igorwolfs/bldc-hw/rev_1/simulations/openems_trace_sims/kicad/3d_models/ATA6560-GAQW--3DModel-STEP-455599.STEP

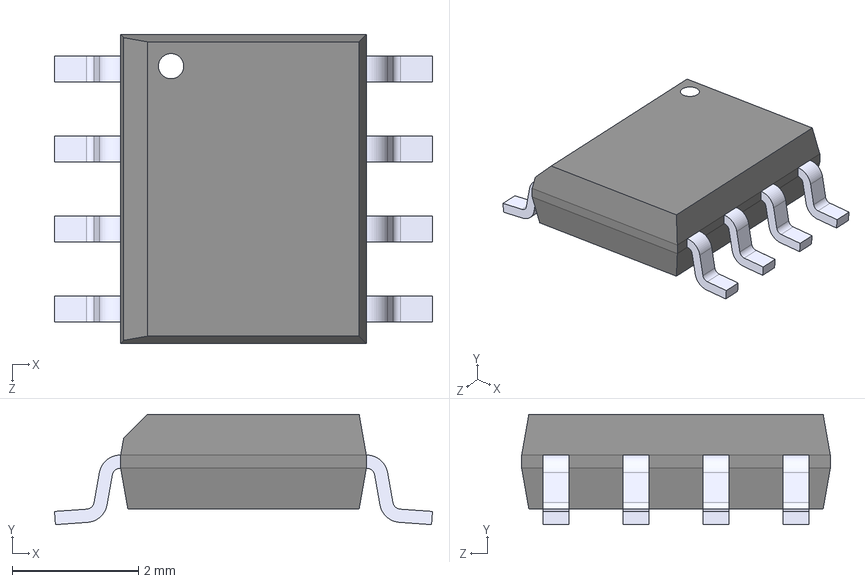
[picture p1: CAD file, 2024-08-09, an earlier design]
rev_1/simulations/openems_trace_sims/kicad/3d_models/ATA6560-GAQW--3DModel-STEP-455599.STEP
6.00 x 1.75 x 4.90 mm
