igorwolfs/bldc-hw/rev_1/simulations/openems_trace_sims/openems_files/exporting_stl.stl

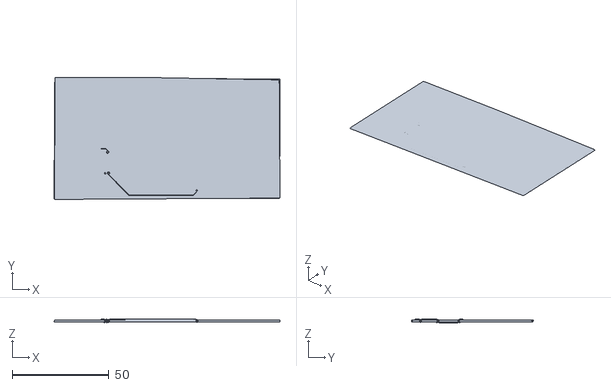
[picture p2: CAD file, 2024-12-03, an earlier design]
rev_1/simulations/openems_trace_sims/openems_files/exporting_stl.stl
116.7 x 62.9 x 1.60
