igorwolfs/bldc-hw/rev_1/simulations/openems_trace_sims/kicad/3d_models/Texas_R-PUSON-N8_USON-8-1EP_1.6x2.1mm_P0.5mm_EP0.40x1.7mm.step

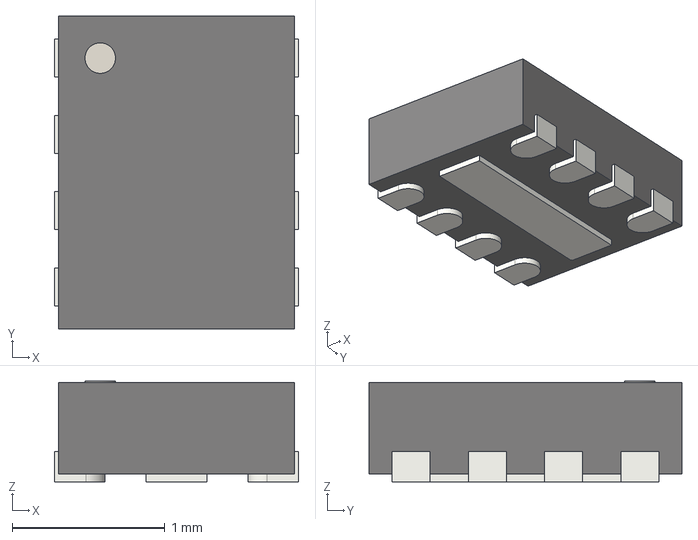
[picture p3: CAD file, 2024-08-09, an earlier design]
rev_1/simulations/openems_trace_sims/kicad/3d_models/Texas_R-PUSON-N8_USON-8-1EP_1.6x2.1mm_P0.5mm_EP0.40x1.7mm.step
1.60 x 2.05 x 0.66 mm
