igorwolfs/bldc-hw/rev_1/simulations/openems_trace_sims/kicad/3d_models/HRO_TYPE-C-31-M-12.step

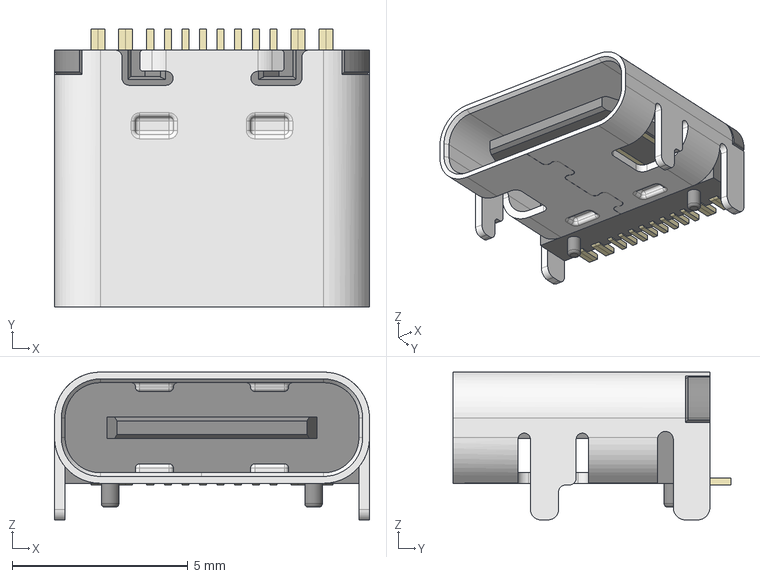
[picture p4: CAD file, 2024-08-04, an earlier design]
rev_1/simulations/openems_trace_sims/kicad/3d_models/HRO_TYPE-C-31-M-12.step
8.95 x 7.90 x 4.20 mm
