igorwolfs/bldc-hw/rev_1/simulations/openems_trace_sims/kicad/3d_models/SOIC8.STEP

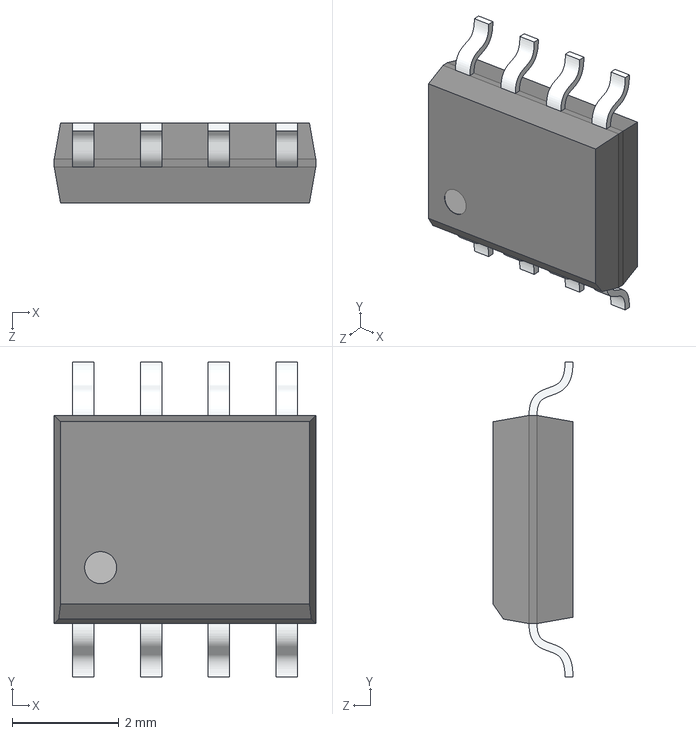
[picture p5: CAD file, 2024-08-04, an earlier design]
rev_1/simulations/openems_trace_sims/kicad/3d_models/SOIC8.STEP
4.90 x 5.90 x 1.50 mm
