igorwolfs/bldc-hw/rev_1/kicad/bldc_project.kicad_pcb

## KiCad design rev_1/kicad/bldc_project.kicad_pcb (2025-05-17, an earlier design)

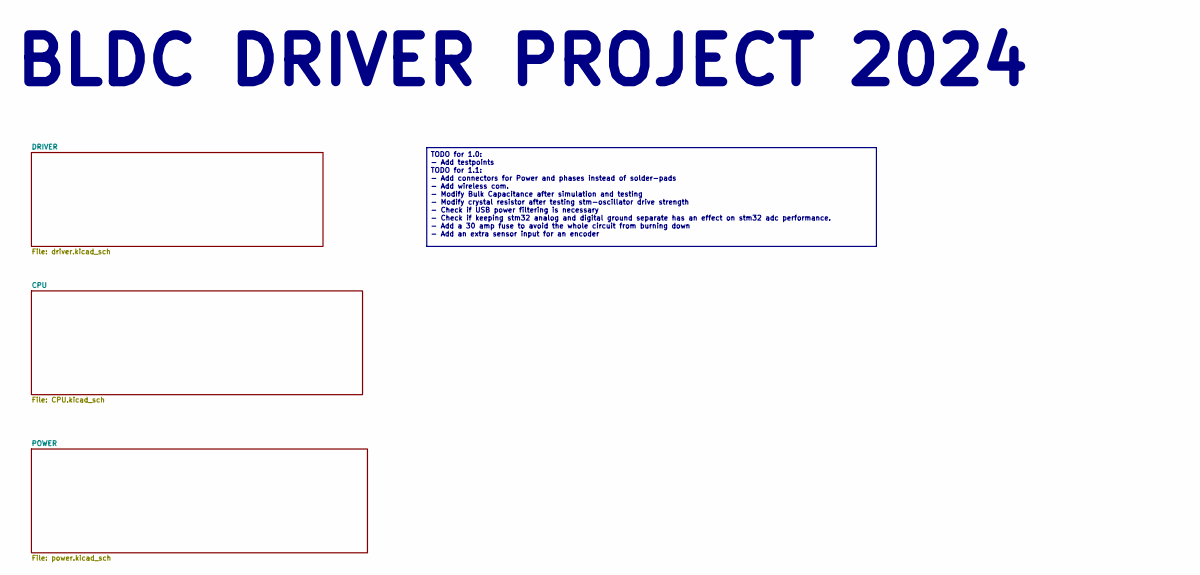
[picture p10: schematic bldc_project.kicad_sch, BLDC Driver Project]

Notes on the sheet:
BLDC DRIVER PROJECT 2024
TODO for 1.0: - Add testpoints TODO for 1.1: - Add connectors for Power and phases instead of solder-pads - Add wireless com. - Modify Bulk Capacitance after simulation and testing - Modify crystal resistor after testing stm-oscillator drive strength - Check if USB power filtering is necessary - Ch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

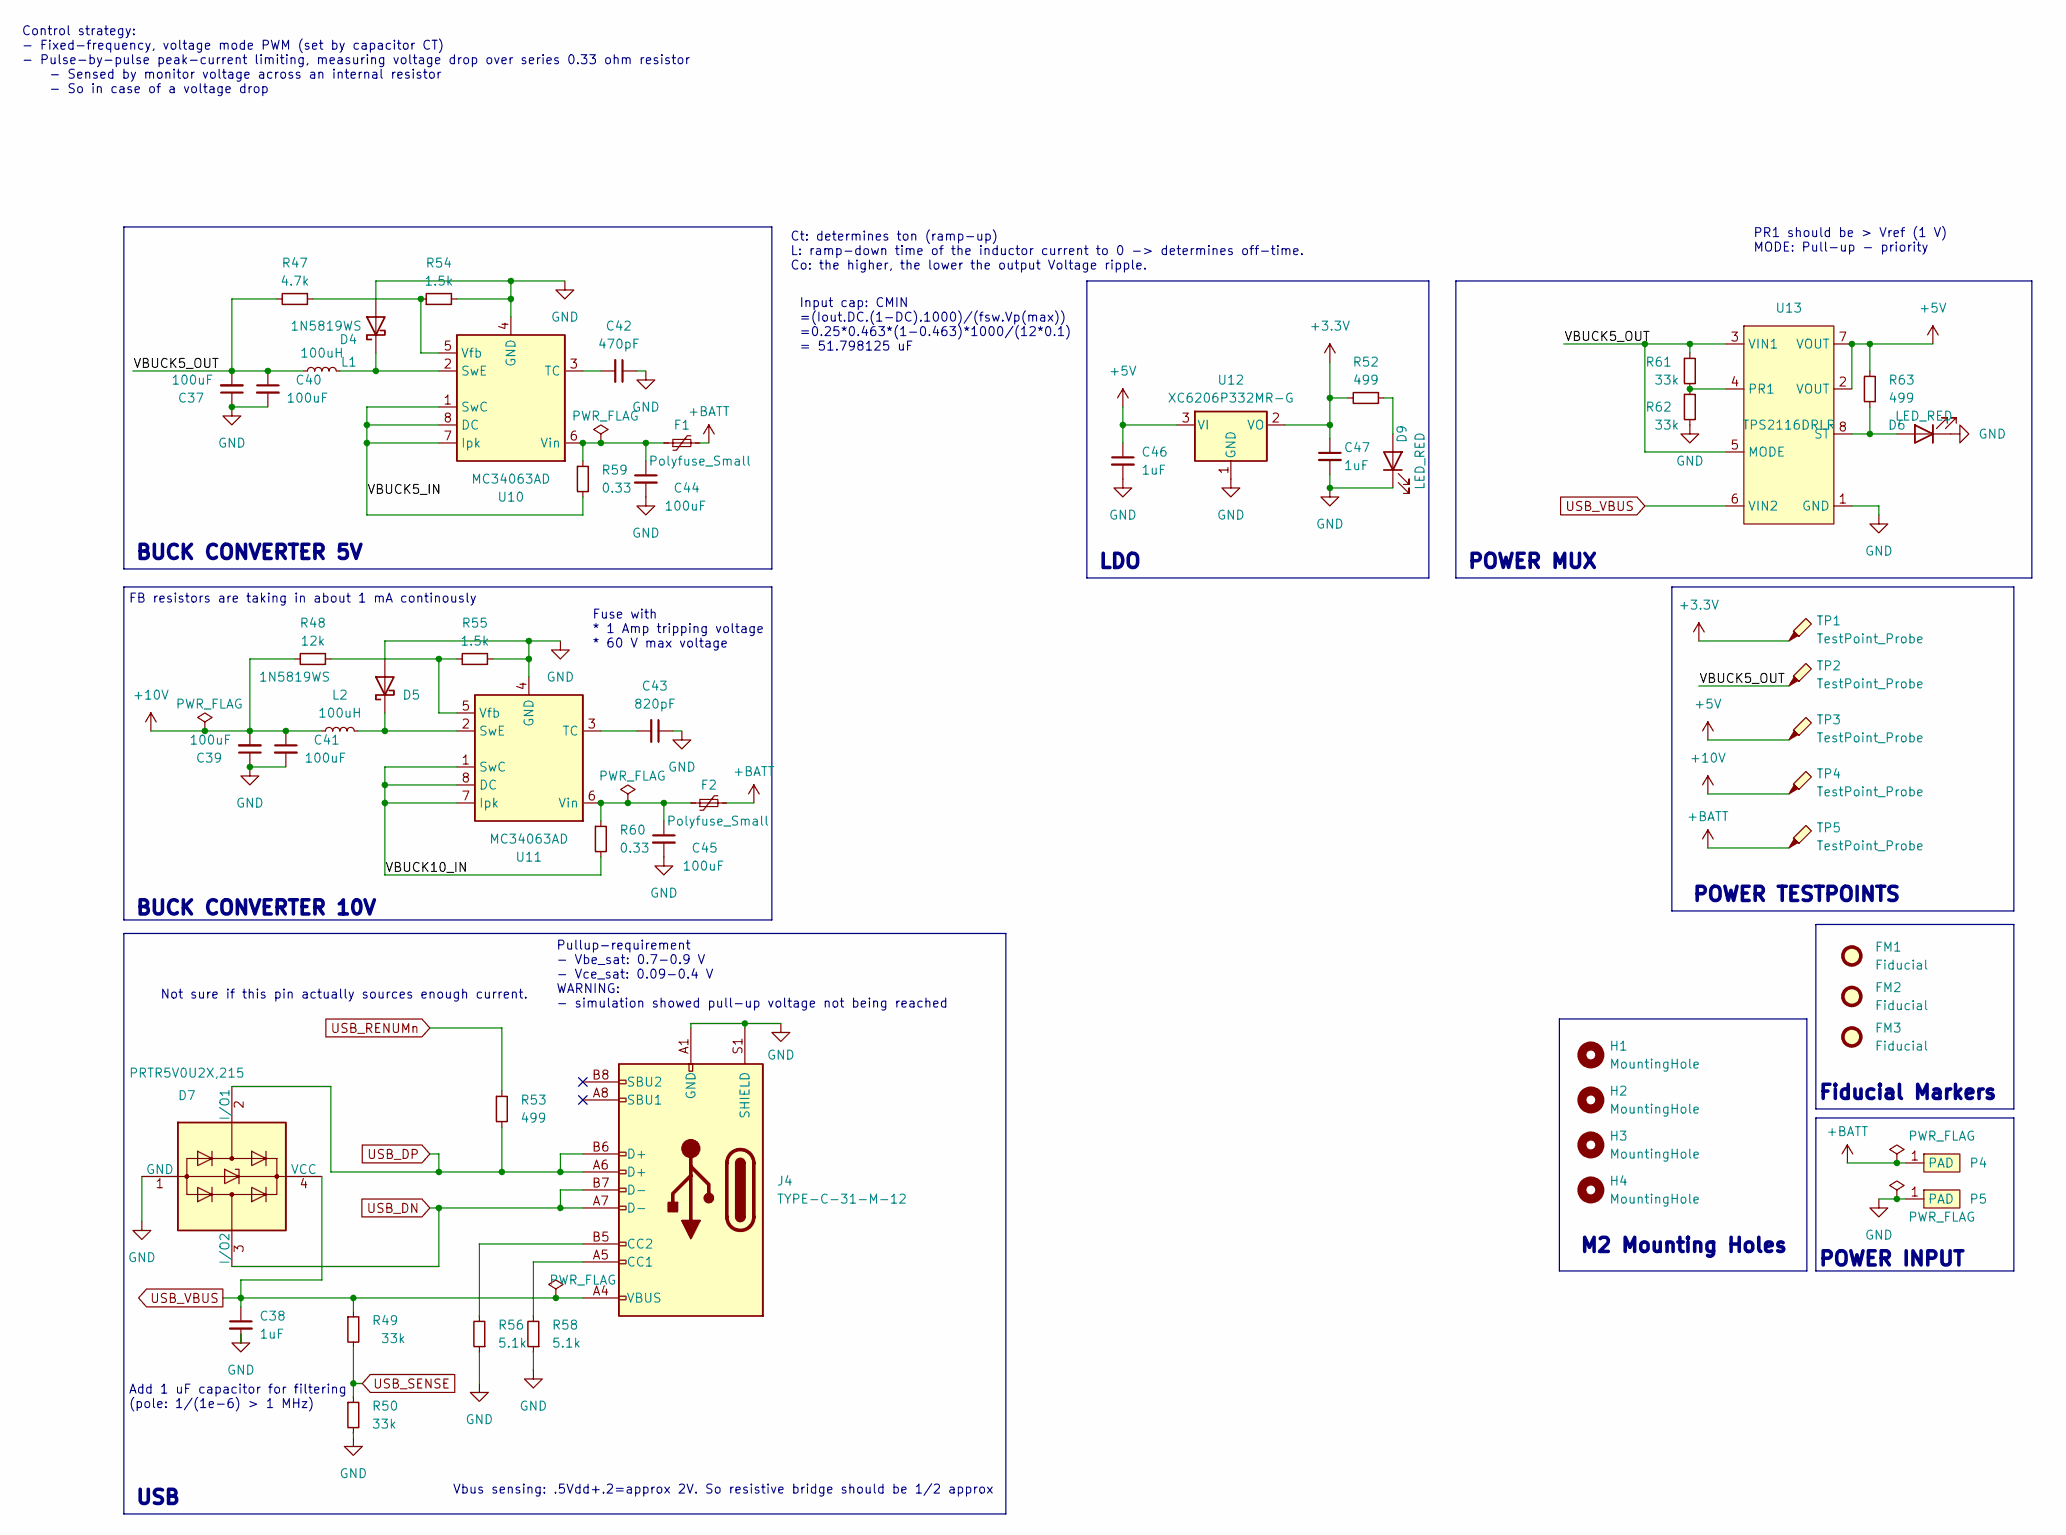
[picture p11: schematic power.kicad_sch, BLDC Driver Project]

Parts:
C37, C39, C40, C41, C44, C45: 100uF; C_1210_3225Metric; Manufacturing part numb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 CA55-B6R3M107T; LCSC Part Number C568913
C38, C46, C47: 1uF; C_1206_3216Metric; Manufacturing part numb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 CL31B105KBHNNNE; LCSC Part Number C1848
C42: 470pF; C_0603_1608Metric; Manufacturing part numb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 0603B471K500NT; LCSC Part Number C1620
C43: 820pF; C_0805_2012Metric_Pad1.18x1.45mm_HandSolder; Manufacturing part numb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 CL21B821KBANNNC; LCSC Part Number C296722
D4, D5: 1N5819WS; D_SOD-323; Manufacturing part numb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 1N5819WS; LCSC Part Number C191023
D6, D9: LED_RED; LED_0603_1608Metric; Manufacturing part numb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 F.0603.00139/P2-0603R1TS2-06T-002; LCSC Part Number C7496820
D7: PRTR5V0U2X,215; SOT-143; Manufacturing part numb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 PRTR5V0U2X,215; LCSC Part Number C12333
F1, F2: Polyfuse_Small; Fuse_1812_4532Metric; Manufacturing part numb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 BSMD1812-050-60V; LCSC Part Number C883142
FM1, FM2, FM3: Fiducial; Fiducial_1mm_Mask2mm
H1, H2, H3, H4: MountingHole; MountingHole_1.152mm_jlcpcb
J4: TYPE-C-31-M-12; USB_C_Receptacle_HRO_TYPE-C-31-M-12; Manufacturing part numb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 TYPE-C-31-M-12; LCSC Part Number C165948
L1, L2: 100uH; L_Sunlord_SWPA6045S; Manufacturing part numb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 SWPA6045S101MT; LCSC Part Number C60633
P4, P5: SolderWirePad_1x01_SMD_5x10mm
R47: 4.7k; R_0805_2012Metric; Manufacturing part numb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 0805W8F4701T5E; LCSC Part Number C17673
R48: 12k; R_0603_1608Metric; Manufacturing part numb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 0603WAF1202T5E; LCSC Part Number C22790
R49, R50, R61, R62: 33k; R_0603_1608Metric; Manufacturing part numb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 0603WAF3302T5E; LCSC Part Number C4216
R52, R53, R63: 499; R_0402_1005Metric; Manufacturing part numb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 0402WGF4990TCE; LCSC Part Number C4125
R54, R55: 1.5k; R_0805_2012Metric; Manufacturing part numb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 0805W8F1501T5E; LCSC Part Number C4310
R56, R58: 5.1k; R_0805_2012Metric; Manufacturing part numb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 0805W8F5101T5E; LCSC Part Number C27834
R59, R60: 0.33; R_1206_3216Metric; Manufacturing part numb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 1206W4J033KT5E; LCSC Part Number C25347
TP1, TP2, TP3, TP4, TP5: TestPoint_Probe; TestPoint_THTPad_D1.0mm_Drill0.5mm
U10, U11: MC34063AD; SOIC-8_3.9x4.9mm_P1.27mm; Manufacturing part numb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 MC34063; LCSC Part Number C5349988
U12: XC6206P332MR-G; SOT-23; Manufacturing part numb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 XC6206P332MR-G; LCSC Part Number C5446
U13: TPS2116DRLR; SOT-583-8; Manufacturing part numb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 TPS2116DRLR; LCSC Part Number C3235557

Connections:
+3.3V: C47.1, R52.2, TP1.1, U12.2 (VO); also elsewhere on the board
+5V: C46.1, R63.2, TP3.1, U12.3 (VI), U13.2 (VOUT), U13.7 (VOUT); also elsewhere on the board
+10V: C39.2, C41.1, L2.1, R48.2, TP4.1; also elsewhere on the board
+BATT: F1.2, F2.2, P4.1 (PAD), TP5.1; also elsewhere on the board
/POWER/VBUCK5_IN: R59.2, U10.1 (SwC), U10.7 (Ipk), U10.8 (DC)
/POWER/VBUCK5_OUT: C37.2, C40.1, L1.1, R47.2, R61.1, TP2.1, U13.3 (VIN1), U13.5 (MODE)
/POWER/VBUCK10_IN: R60.2, U11.1 (SwC), U11.7 (Ipk), U11.8 (DC)
GND: C37.1, C38.2, C39.1, C40.2, C41.2, C42.1, C43.1, C44.2, C45.2, C46.2, C47.2, D4.2 (A), D5.2 (A), D6.1 (K), D7.1 (GND), D9.1 (K), J4.A1 (GND), J4.A12 (GND), J4.B1 (GND), J4.B12 (GND), J4.S1 (SHIELD), P5.1 (PAD), R50.2, R54.2, R55.2, R56.1, R58.1, R62.2, U10.4 (GND), U11.4 (GND), U12.1 (GND), U13.1 (GND); also elsewhere on the board
unnamed: D4.1 (K), L1.2, U10.2 (SwE)
unnamed: D5.1 (K), L2.2, U11.2 (SwE)
unnamed: D6.2 (A), R63.1, U13.8 (ST)
unnamed: D9.2 (A), R52.1
unnamed: J4.A5 (CC1), R58.2
unnamed: J4.B5 (CC2), R56.2
unnamed: C42.2, U10.3 (TC)
unnamed: R47.1, R54.1, U10.5 (Vfb)
unnamed: C44.1, F1.1, R59.1, U10.6 (Vin)
unnamed: C43.2, U11.3 (TC)
unnamed: R48.1, R55.1, U11.5 (Vfb)
unnamed: C45.1, F2.1, R60.1, U11.6 (Vin)
unnamed: R61.2, R62.1, U13.4 (PR1)
USB_DN: D7.3 (I/O2), J4.A7 (D-), J4.B7 (D-); also elsewhere on the board
USB_DP: D7.2 (I/O1), J4.A6 (D+), J4.B6 (D+), R53.2; also elsewhere on the board
USB_RENUMn: R53.1; also elsewhere on the board
USB_SENSE: R49.2, R50.1; also elsewhere on the board
USB_VBUS: C38.1, D7.4 (VCC), J4.A4 (VBUS), J4.A9 (VBUS), J4.B4 (VBUS), J4.B9 (VBUS), R49.1, U13.6 (VIN2); also elsewhere on the board

Notes on the sheet:
PR1 should be > Vref (1 V) MODE: Pull-up - priority
Pullup-requirement - Vbe_sat: 0.7-0.9 V - Vce_sat: 0.09-0.4 V WARNING: - simulation showed pull-up voltage not being reached
Vbus sensing: .5Vdd+.2=approx 2V. So resistive bridge should be 1/2 approx
Not sure if this pin actually sources enough current.
Add 1 uF capacitor for filtering (pole: 1/(1e-6) > 1 MHz)
FB resistors are taking in about 1 mA continously
Fuse with * 1 Amp tripping voltage * 60 V max voltage
Input cap: CMIN =(Iout.DC.(1-DC).1000)/(fsw.Vp(max)) =0.25*0.463*(1-0.463)*1000/(12*0.1) = 51.798125 uF
Ct: determines ton (ramp-up) L: ramp-down time of the inductor current to 0 -> determines off-time. Co: the higher, the lower the output Voltage ripple.
Control strategy: - Fixed-frequency, voltage mode PWM (set by capacitor CT) - Pulse-by-pulse peak-current limiting, measuring voltage drop over series 0.33 ohm resistor - Sensed by monitor voltage across an internal resistor - So in case of a voltage drop
POWER INPUT
USB
Fiducial Markers
POWER TESTPOINTS
LDO
POWER MUX
BUCK CONVERTER 5V
BUCK CONVERTER 10V
M2 Mounting Holes

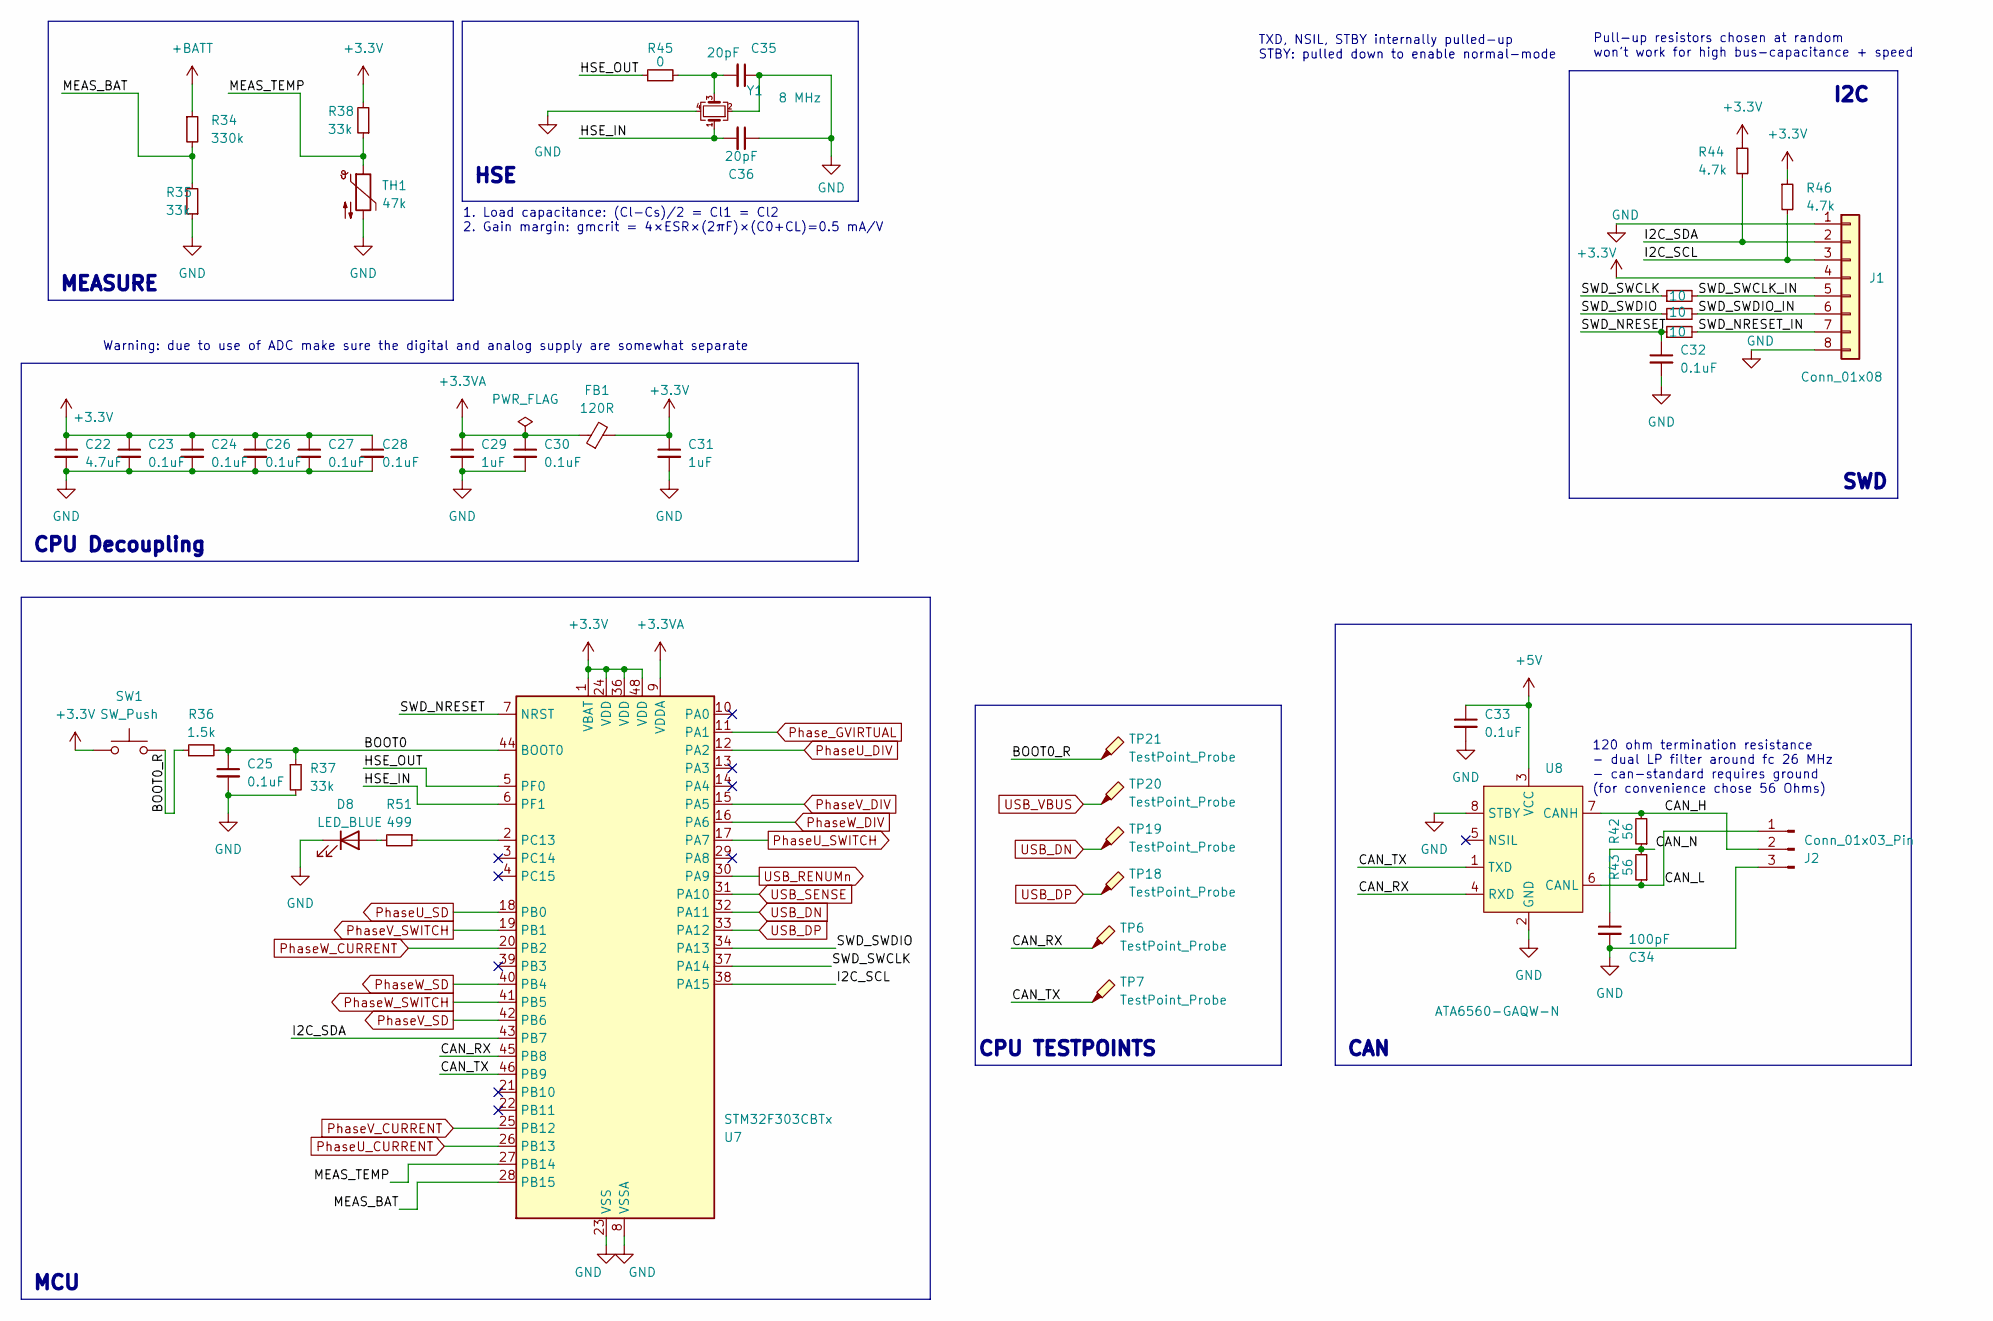
[picture p12: schematic CPU.kicad_sch, BLDC Driver Project]

Parts:
C22: 4.7uF; C_0603_1608Metric; Manufacturing part numb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 CL10A475KO8NNNC; LCSC Part Number C19666
C23, C24, C25, C26, C27, C28, C30, C32, C33: 0.1uF; C_0402_1005Metric; Manufacturing part numb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 CL05B104KB54PNC; LCSC Part Number C307331
C29, C31: 1uF; C_1206_3216Metric; Manufacturing part numb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 CL31B105KBHNNNE; LCSC Part Number C1848
C34: 100pF; C_0603_1608Metric; Manufacturing part numb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 CL10C101JB8NNNC; LCSC Part Number C14858
C35, C36: 20pF; C_0603_1608Metric; Manufacturing part numb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 CL10C200JB81PNC; LCSC Part Number C346210
D8: LED_BLUE; LED_0603_1608Metric; Manufacturing part numb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 F.0603.00026/P2-0603B1TS2-06T-001; LCSC Part Number C7496819
FB1: 120R; R_0603_1608Metric; Manufacturing part numb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 BLM18PG121SN1D; LCSC Part Number C14709
J1: Conn_01x08; PinHeader_1x08_P2.54mm_Vertical; Manufacturing part numb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 HB-PH3-25418PB2GOP; LCSC Part Number C6332201
J2: Conn_01x03_Pin; PinHeader_1x03_P2.54mm_Vertical; Manufacturing part numb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 HB-PH3-25413PB2GOP; LCSC Part Number C6332196
R34: 330k; R_0603_1608Metric; Manufacturing part numb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 0603WAF3303T5E; LCSC Part Number C23137
R35, R37, R38: 33k; R_0603_1608Metric; Manufacturing part numb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 0603WAF3302T5E; LCSC Part Number C4216
R36: 1.5k; R_0805_2012Metric; Manufacturing part numb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 0805W8F1501T5E; LCSC Part Number C4310
R41, R57, R64: 10; R_0402_1005Metric; Manufacturing part numb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 0402WGF100JTCE; LCSC Part Number C25077
R42, R43: 56; R_0603_1608Metric; Manufacturing part numb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 0603WAD560JT5E; LCSC Part Number C423025
R44, R46: 4.7k; R_0805_2012Metric; Manufacturing part numb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 0805W8F4701T5E; LCSC Part Number C17673
R45: 0; R_0402_1005Metric_Pad0.72x0.64mm_HandSolder; Manufacturing part numb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 0402WGF0000TCE; LCSC Part Number C17168
R51: 499; R_0402_1005Metric; Manufacturing part numb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 0402WGF4990TCE; LCSC Part Number C4125
SW1: SW_Push; TS-1088_w4.00xD3.00; Manufacturing part numb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 TS-1088-AR02016; LCSC Part Number C720477
TH1: 47k; R_0402_1005Metric; Manufacturing part numb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 SDNT1005X473F4050FTF; LCSC Part Number C279702
TP6, TP7, TP18, TP19, TP20, TP21: TestPoint_Probe; TestPoint_THTPad_D1.0mm_Drill0.5mm
U7: STM32F303CBTx; LQFP-48_7x7mm_P0.5mm; Manufacturing part numb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 STM32F303CBT6; LCSC Part Number C108516
U8: ATA6560-GAQW-N; SOIC-8-N8_3.9x4.9mm_P1.27mm; Manufacturing part numb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 ATA6560-GAQW-N; LCSC Part Number C2671262
Y1: 8 MHz; Crystal_SMD_3225-4Pin_3.2x2.5mm; Manufacturing part numb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 7325-0800A2010-00; LCSC Part Number C389817

Connections:
+3.3V: C22.1, C23.1, C24.1, C26.1, C27.1, C28.1, C31.1, FB1.2, J1.4, R38.2, R44.1, R46.1, SW1.1, U7.1 (VBAT), U7.24 (VDD), U7.36 (VDD), U7.48 (VDD); also elsewhere on the board
+3.3VA: C29.1, C30.1, FB1.1, U7.9 (VDDA)
+5V: C33.1, U8.3 (VCC); also elsewhere on the board
+BATT: R34.1; also elsewhere on the board
/CPU/BOOT0: C25.1, R36.2, R37.1, U7.44 (BOOT0)
/CPU/BOOT0_R: R36.1, SW1.2, TP21.1
/CPU/CAN_H: J2.2, R42.2, U8.7 (CANH)
/CPU/CAN_L: J2.1, R43.1, U8.6 (CANL)
/CPU/CAN_N: C34.1, R42.1, R43.2
/CPU/CAN_RX: TP6.1, U7.45 (PB8), U8.4 (RXD)
/CPU/CAN_TX: TP7.1, U7.46 (PB9), U8.1 (TXD)
/CPU/HSE_IN: C36.2, U7.6 (PF1), Y1.1
/CPU/HSE_OUT: R45.1, U7.5 (PF0)
/CPU/I2C_SCL: J1.3, R46.2, U7.38 (PA15)
/CPU/I2C_SDA: J1.2, R44.2, U7.43 (PB7)
/CPU/MEAS_BAT: R34.2, R35.2, U7.28 (PB15)
/CPU/MEAS_TEMP: R38.1, TH1.1, U7.27 (PB14)
/CPU/SWD_NRESET: C32.1, R41.1, U7.7 (NRST)
/CPU/SWD_NRESET_IN: J1.7, R41.2
/CPU/SWD_SWCLK: R57.1, U7.37 (PA14)
/CPU/SWD_SWCLK_IN: J1.5, R57.2
/CPU/SWD_SWDIO: R64.1, U7.34 (PA13)
/CPU/SWD_SWDIO_IN: J1.6, R64.2
GND: C22.2, C23.2, C24.2, C25.2, C26.2, C27.2, C28.2, C29.2, C30.2, C31.2, C32.2, C33.2, C34.2, C35.1, C36.1, D8.1 (K), J1.1, J1.8, J2.3, R35.1, R37.2, TH1.2, U7.8 (VSSA), U7.23 (VSS), U7.35 (VSS), U7.47 (VSS), U8.2 (GND), U8.8 (STBY), Y1.2, Y1.4; also elsewhere on the board
unnamed: C35.2, R45.2, Y1.3
unnamed: D8.2 (A), R51.2
unnamed: R51.1, U7.2 (PC13)
PhaseU_CURRENT: U7.26 (PB13); also elsewhere on the board
PhaseU_DIV: U7.12 (PA2); also elsewhere on the board
PhaseU_SD: U7.18 (PB0); also elsewhere on the board
PhaseU_SWITCH: U7.17 (PA7); also elsewhere on the board
PhaseV_CURRENT: U7.25 (PB12); also elsewhere on the board
PhaseV_DIV: U7.15 (PA5); also elsewhere on the board
PhaseV_SD: U7.42 (PB6); also elsewhere on the board
PhaseV_SWITCH: U7.19 (PB1); also elsewhere on the board
PhaseW_CURRENT: U7.20 (PB2); also elsewhere on the board
PhaseW_DIV: U7.16 (PA6); also elsewhere on the board
PhaseW_SD: U7.40 (PB4); also elsewhere on the board
PhaseW_SWITCH: U7.41 (PB5); also elsewhere on the board
Phase_GVIRTUAL: U7.11 (PA1); also elsewhere on the board
USB_DN: TP19.1, U7.32 (PA11); also elsewhere on the board
USB_DP: TP18.1, U7.33 (PA12); also elsewhere on the board
USB_RENUMn: U7.30 (PA9); also elsewhere on the board
USB_SENSE: U7.31 (PA10); also elsewhere on the board
USB_VBUS: TP20.1; also elsewhere on the board

Notes on the sheet:
TXD, NSIL, STBY internally pulled-up STBY: pulled down to enable normal-mode
Pull-up resistors chosen at random won't work for high bus-capacitance + speed
1. Load capacitance: (Cl-Cs)/2 = Cl1 = Cl2 2. Gain margin: gmcrit = 4×ESR×(2πF)×(C0+CL)=0.5 mA/V
Warning: due to use of ADC make sure the digital and analog supply are somewhat separate
120 ohm termination resistance - dual LP filter around fc 26 MHz - can-standard requires ground (for convenience chose 56 Ohms)
MEASURE
HSE
MCU
CPU Decoupling
SWD
CPU TESTPOINTS
I2C
CAN

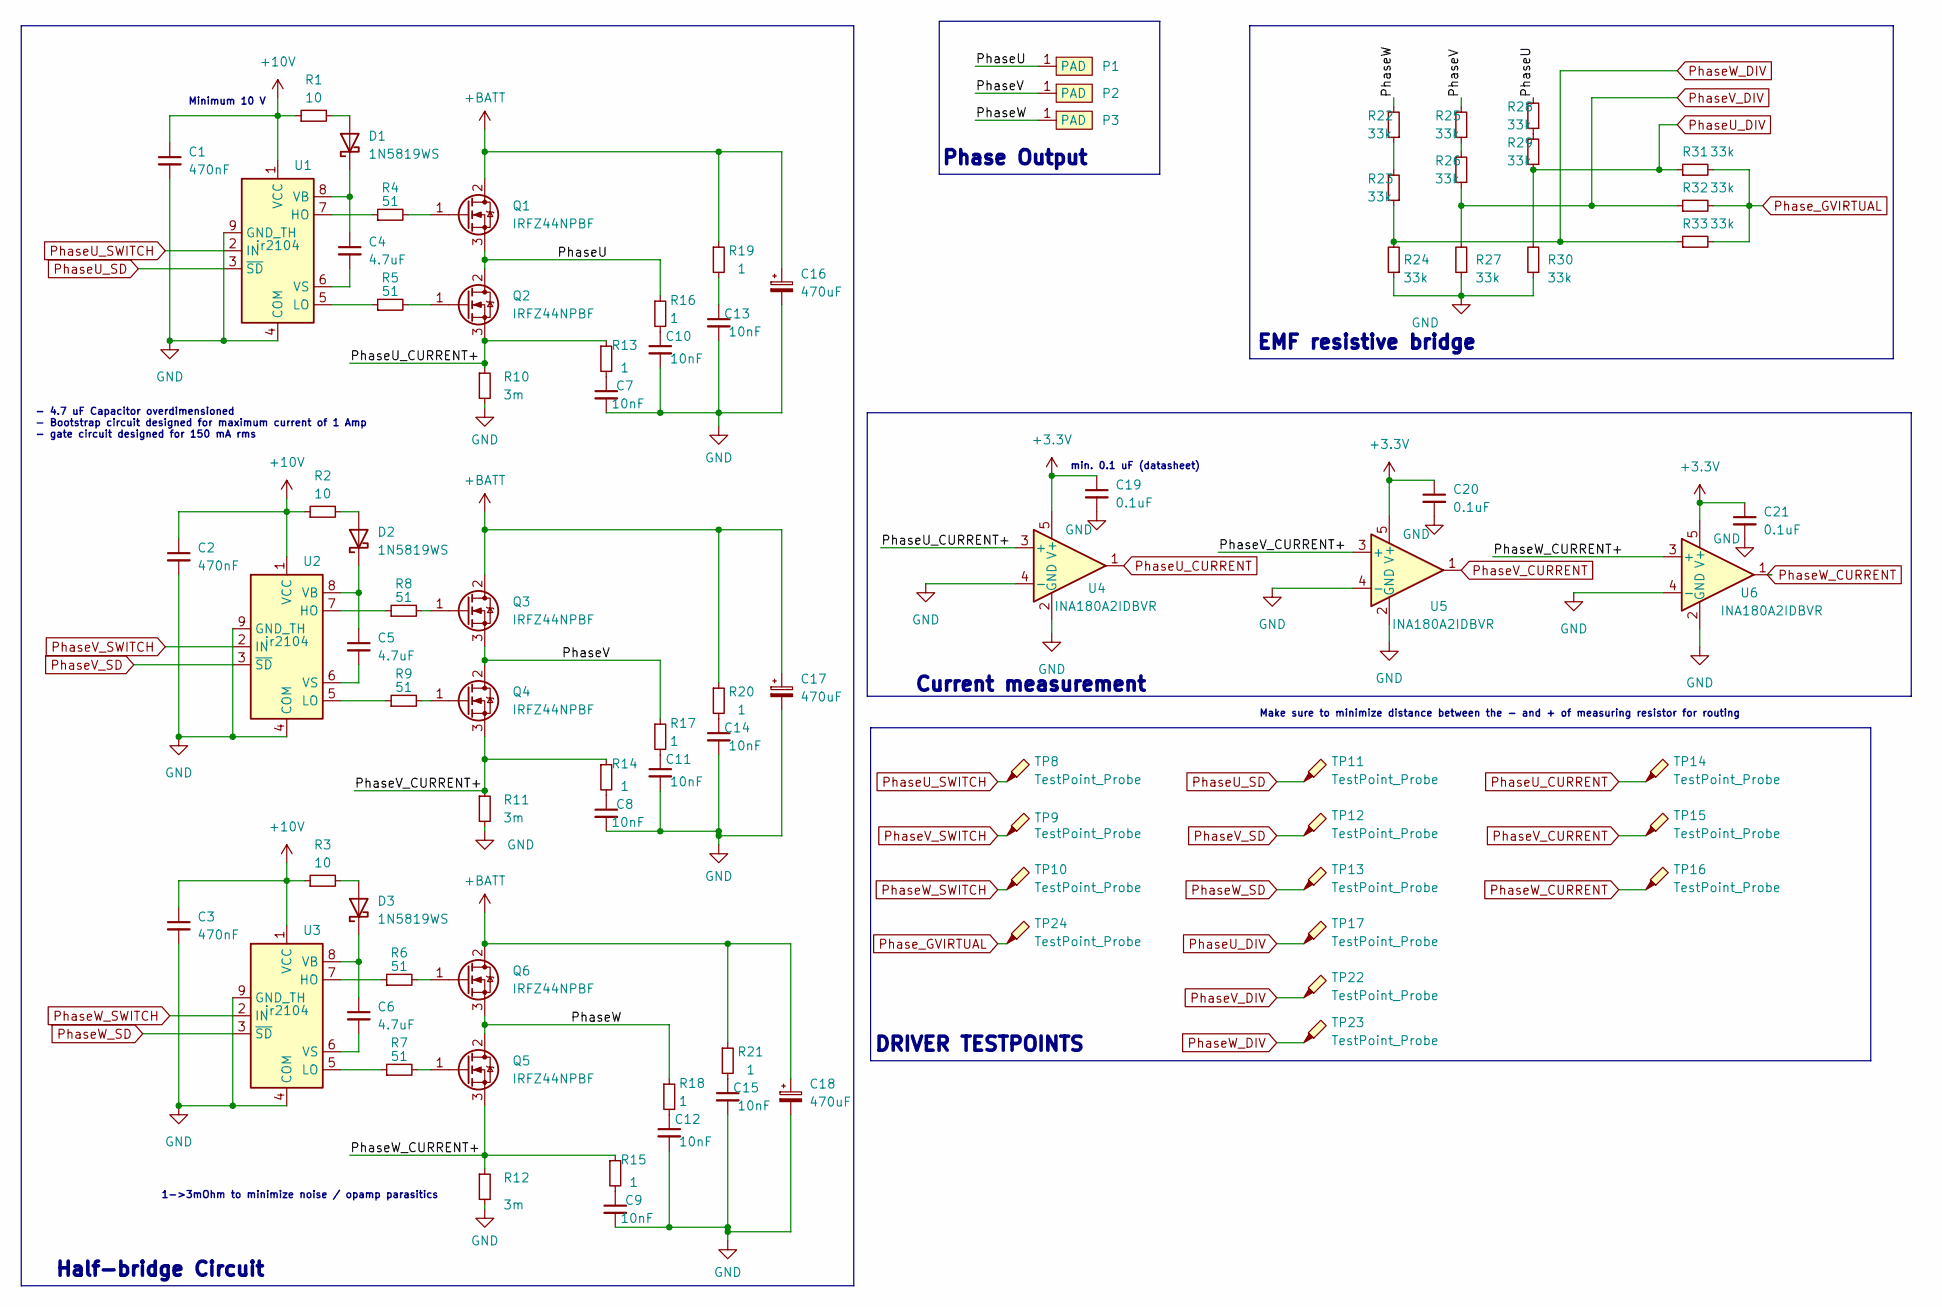
[picture p13: schematic driver.kicad_sch, BLDC Driver Project]

Parts:
C1, C2, C3: 470nF; C_0603_1608Metric; Manufacturing part numb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 CL10B474KA8NNNC; LCSC Part Number C1623
C4, C5, C6: 4.7uF; C_0603_1608Metric; Manufacturing part numb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 CL10A475KO8NNNC; LCSC Part Number C19666
C7, C8, C9, C10, C11, C12, C13, C14, C15: 10nF; C_0402_1005Metric; Manufacturing part numb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 CL05B103KB5NNNC; LCSC Part Number C15195
C16, C17, C18: 470uF; C_Radial_D10.0mm_H20.0mm_P5.00mm; Manufacturing part numb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 ERS1HM471G20OT; LCSC Part Number C106666
C19, C20, C21: 0.1uF; C_0402_1005Metric; Manufacturing part numb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 CL05B104KB54PNC; LCSC Part Number C307331
D1, D2, D3: 1N5819WS; D_SOD-323; Manufacturing part numb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 1N5819WS; LCSC Part Number C191023
P1, P2, P3: SolderWirePad_1x01_SMD_5x10mm
Q1, Q2, Q3, Q4, Q5, Q6: IRFZ44NPBF; TO-220-3_Vertical; Manufacturing part numb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 IRFZ44NPBF; LCSC Part Number C2586
R1, R2, R3: 10; R_1206_3216Metric; Manufacturing part numb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 1206W4F100JT5E; LCSC Part Number C17903
R4, R5, R6, R7, R8, R9: 51; R_1206_3216Metric; Manufacturing part numb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 1206W4F510JT5E; LCSC Part Number C18019
R10, R11, R12: 3m; R_2512_6332Metric; Manufacturing part numb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 LR2512D-2W-3mR-1%; LCSC Part Number C500615
R13, R14, R15, R16, R17, R18, R19, R20, R21: 1; R_0603_1608Metric; Manufacturing part numb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 0603WAF100KT5E; LCSC Part Number C22936
R22, R23, R24, R25, R26, R27, R28, R29, R30, R31, R32, R33: 33k; R_0603_1608Metric; Manufacturing part numb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 0603WAF3302T5E; LCSC Part Number C4216
TP8, TP9, TP10, TP11, TP12, TP13, TP14, TP15, TP16, TP17, TP22, TP23, TP24: TestPoint_Probe; TestPoint_THTPad_D1.0mm_Drill0.5mm
U1, U2, U3: ir2104; SOIC-8-1EP_3.9x4.9mm_P1.27mm_EP2.29x3mm; Manufacturing part numb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 IR2104STRPBF-JSM; LCSC Part Number C5804631
U4, U5, U6: INA180A2IDBVR; SOT-23-5; Manufacturing part numb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 INA180A2IDBVR; LCSC Part Number C192764

Connections:
+3.3V: C19.1, C20.1, C21.1, U4.5 (V+), U5.5 (V+), U6.5 (V+); also elsewhere on the board
+10V: C1.1, C2.1, C3.1, R1.1, R2.1, R3.1, U1.1 (VCC), U2.1 (VCC), U3.1 (VCC); also elsewhere on the board
+BATT: C16.1, C17.1, C18.1, Q1.2 (D), Q3.2 (D), Q6.2 (D), R19.1, R20.1, R21.1; also elsewhere on the board
/DRIVER/PhaseU: P1.1 (PAD), Q1.3 (S), Q2.2 (D), R16.1, R28.2
/DRIVER/PhaseU_CURRENT+: Q2.3 (S), R10.1, R13.1, U4.3 (+)
/DRIVER/PhaseV: P2.1 (PAD), Q3.3 (S), Q4.2 (D), R17.1, R25.2
/DRIVER/PhaseV_CURRENT+: Q4.3 (S), R11.1, R14.1, U5.3 (+)
/DRIVER/PhaseW: P3.1 (PAD), Q5.2 (D), Q6.3 (S), R18.1, R22.2
/DRIVER/PhaseW_CURRENT+: Q5.3 (S), R12.1, R15.1, U6.3 (+)
GND: C1.2, C2.2, C3.2, C7.2, C8.2, C9.2, C10.2, C11.2, C12.2, C13.2, C14.2, C15.2, C16.2, C17.2, C18.2, C19.2, C20.2, C21.2, R10.2, R11.2, R12.2, R24.1, R27.1, R30.1, U1.4 (COM), U1.9 (GND_TH), U2.4 (COM), U2.9 (GND_TH), U3.4 (COM), U3.9 (GND_TH), U4.2 (GND), U4.4 (-), U5.2 (GND), U5.4 (-), U6.2 (GND), U6.4 (-); also elsewhere on the board
unnamed: C7.1, R13.2
unnamed: C8.1, R14.2
unnamed: C9.1, R15.2
unnamed: C10.1, R16.2
unnamed: C11.1, R17.2
unnamed: C12.1, R18.2
unnamed: C13.1, R19.2
unnamed: C14.1, R20.2
unnamed: C15.1, R21.2
unnamed: D1.2 (A), R1.2
unnamed: C4.1, D1.1 (K), U1.8 (VB)
unnamed: D2.2 (A), R2.2
unnamed: C5.1, D2.1 (K), U2.8 (VB)
unnamed: D3.2 (A), R3.2
unnamed: C6.1, D3.1 (K), U3.8 (VB)
unnamed: Q1.1 (G), R4.2
unnamed: Q2.1 (G), R5.2
unnamed: Q3.1 (G), R8.2
unnamed: Q4.1 (G), R9.2
unnamed: Q5.1 (G), R7.2
unnamed: Q6.1 (G), R6.2
unnamed: R22.1, R23.2
unnamed: R25.1, R26.2
unnamed: R28.1, R29.2
unnamed: R4.1, U1.7 (HO)
unnamed: R5.1, U1.5 (LO)
unnamed: C4.2, U1.6 (VS)
unnamed: R8.1, U2.7 (HO)
unnamed: R9.1, U2.5 (LO)
unnamed: C5.2, U2.6 (VS)
unnamed: R6.1, U3.7 (HO)
unnamed: R7.1, U3.5 (LO)
unnamed: C6.2, U3.6 (VS)
PhaseU_CURRENT: TP14.1, U4.1; also elsewhere on the board
PhaseU_DIV: R29.1, R30.2, R31.1, TP17.1; also elsewhere on the board
PhaseU_SD: TP11.1, U1.3 (~SD); also elsewhere on the board
PhaseU_SWITCH: TP8.1, U1.2 (IN); also elsewhere on the board
PhaseV_CURRENT: TP15.1, U5.1; also elsewhere on the board
PhaseV_DIV: R26.1, R27.2, R32.1, TP22.1; also elsewhere on the board
PhaseV_SD: TP12.1, U2.3 (~SD); also elsewhere on the board
PhaseV_SWITCH: TP9.1, U2.2 (IN); also elsewhere on the board
PhaseW_CURRENT: TP16.1, U6.1; also elsewhere on the board
PhaseW_DIV: R23.1, R24.2, R33.1, TP23.1; also elsewhere on the board
PhaseW_SD: TP13.1, U3.3 (~SD); also elsewhere on the board
PhaseW_SWITCH: TP10.1, U3.2 (IN); also elsewhere on the board
Phase_GVIRTUAL: R31.2, R32.2, R33.2, TP24.1; also elsewhere on the board

Notes on the sheet:
Make sure to minimize distance between the - and + of measuring resistor for routing
min. 0.1 uF (datasheet)
Minimum 10 V
1->3mOhm to minimize noise / opamp parasitics
- 4.7 uF Capacitor overdimensioned - Bootstrap circuit designed for maximum current of 1 Amp - gate circuit designed for 150 mA rms
Half-bridge Circuit
Phase Output
DRIVER TESTPOINTS
EMF resistive bridge
Current measurement

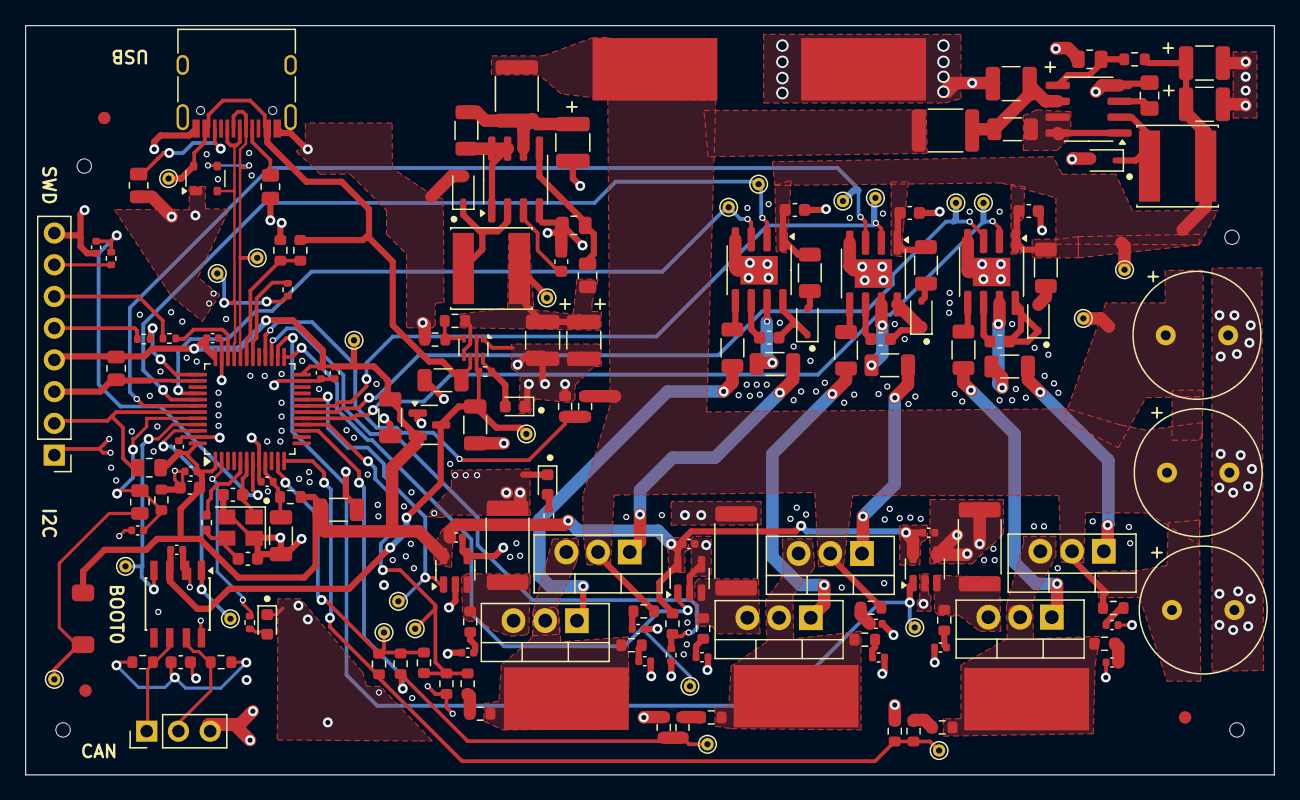
[picture p14: board bldc_project.kicad_pcb from above]

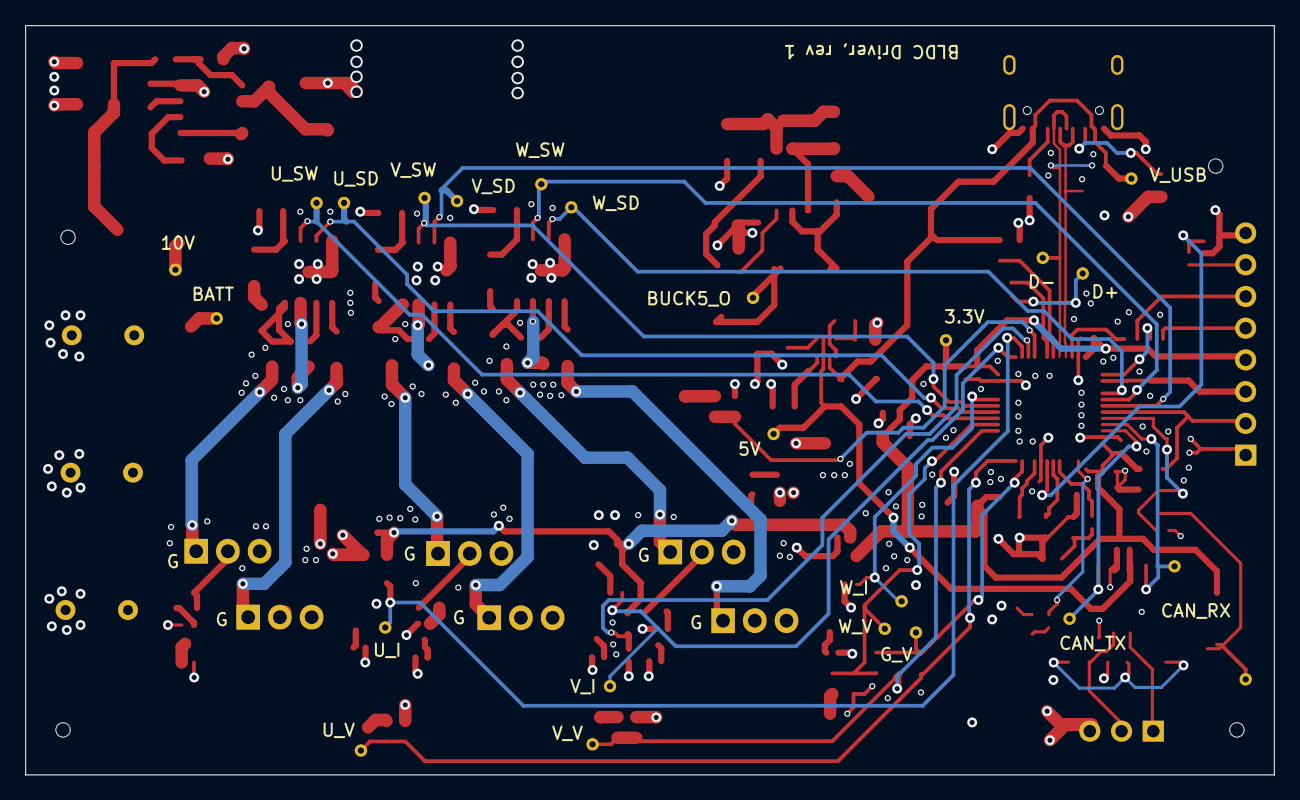
[picture p15: board bldc_project.kicad_pcb from below]

Board: 4 copper layers, 100.0 x 60.0 mm, 183 parts (24 on the bottom side), 101 nets.
