igorwolfs/bldc-hw/rev_1/cubemx/cubemx.ioc

Mcu.UserName=STM32F303CBTx
PA1.Signal=ADC1_IN2
PA10.Signal=GPIO_Input
PA11.Signal=USB_DM
PA12.Signal=USB_DP
PA13.Signal=SYS_JTMS-SWDIO
PA14.Signal=SYS_JTCK-SWCLK
PA15.Signal=I2C1_SCL
PA2.Signal=ADC1_IN3
PA5.Signal=ADC2_IN2
PA6.Signal=ADC2_IN3
PA7.Signal=TIM1_CH1N
PA9.Signal=GPIO_Input
PB0.Signal=TIM1_CH2N
PB1.Signal=TIM1_CH3N
PB12.Signal=ADC4_IN3
PB13.Signal=ADC3_IN5
PB14.Signal=ADC4_IN4
PB15.Signal=ADC4_IN5
PB2.Signal=ADC2_IN12
PB4.Signal=TIM8_CH2N
PB5.Signal=TIM8_CH3N
PB6.Signal=S_TIM8_CH1
PB7.Signal=I2C1_SDA
PB8.Signal=CAN_RX
PB9.Signal=CAN_TX
PC13.Signal=GPIO_Output
PF0-OSC_IN.Signal=RCC_OSC_IN
PF1-OSC_OUT.Signal=RCC_OSC_OUT
