igorwolfs/bldc-hw/(commit log)

2024-03-30 [kicad] [simulations] v1.0 Fet drivers + fet
    [bldc_project.kicad_pcb, bldc_project.kicad_sch]
2024-03-30 [simulations] Simulated 3 OPAMP-circuits + RC filter, chose INA1803A, [kicad] Added current measuring circuit + future todo checks
    [bldc_project.kicad_sch]
2024-03-31 [kicad] Added extra empty schematic for CPU, temp and ocillator, changed shunt resistors + changed opamp to gain 50 [simulation] added simulation for opamp with gain 50
    [CPU.kicad_sch, bldc_project.kicad_sch, driver_fb_circuit.kicad_sch]
2024-03-31 [kicad] Added HSE + HSE calculation
    [CPU.kicad_sch]
2024-04-01 [kicad] BOOT0 pin done + SWD interface done
    [CPU.kicad_sch]
2024-04-01 [kicad] Added resistive bridge + virtual star for back-EMF meausrement, [cubemx] Added cubemx configuration file |TODO| Check ADC-DMA, ADC-CMP and interrupt with ADC functions, ADC-DMA
    [CPU.kicad_sch, driver_fb_circuit.kicad_sch]
2024-04-06 [kicad] Added ADC_in, PWM_out labels as well as thermistor + battery management voltage divider | TODO: search for thermistor + CAN-circuit
    [CPU.kicad_sch, driver_fb_circuit.kicad_sch]
2024-04-07 [kicad] added thermistor
    [CPU.kicad_sch]
2024-04-07 [kicad] Added CAN transceiver and todo's
    [communication.kicad_sch]
2024-04-08 [kicad] Added end-connector and differential resistnace
    [communication.kicad_sch]
2024-04-25 Changed USB configuration
    [CPU.kicad_sch, communication.kicad_sch]
2024-04-29 [kicad] Added i2c connection
    [CPU.kicad_sch, communication.kicad_sch, driver_fb_circuit.kicad_sch]
2024-04-29 [ltspice] added MC34063 simulation model
    [CPU.kicad_sch, driver_fb_circuit.kicad_sch]
2024-05-05 Added MC3406 buck simulation, analyse waveforms
2024-05-19 [kicad] Added linear regulator, buck converter, priority-based power-input MUX | TODO: Add complete buck converter circuit, add resistive divider to linear regulator [simulations] Added correct buck 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
    [driver_fb_circuit.kicad_sch]
2024-05-20 [kicad] Added capacitor to buck circuit, added netlabels | TODO: Add pi-filter to usb-c output, add additional 5 V regulator to buck-circuit output with good noise rejection ratio
    [CPU.kicad_sch]
2024-05-29 [kicad] input capacitance added [simulations] added ferrite simulation
    [CPU.kicad_sch]
2024-06-01 brought some order in filter simulations
    [CPU.kicad_sch]
2024-06-02 [scripts] [simulations] Added filter calculation
2024-06-02 working on circuit change
2024-06-04 [buck_converter] Added parts of buck converter calculations
2024-06-11 [simulations] Added debouncing, added RC circuit, cleaned up LC-ladder, [scripts] (filtering) added usb-section, started working on debouncing equations, [kicad] Additional CAN configuration added, f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
    [CPU.kicad_sch, communication.kicad_sch]
2024-06-16 [scripts] added simple debouncing circuit to driver, added rudimentary bootstrap circuit calculation, [simulations] Cleaned up filter simulations
    [CPU.kicad_sch]
2024-07-06 [simulations] Added 10 V and 5 V simulations for buck converter, [scripts] Added bulk capacitor requirement notebook [kicad] Fixed buck converter schematic
    [CPU.kicad_sch, driver_fb_circuit.kicad_sch]
2024-07-11 [scripts] Added bldc equations [simulations] Rearranged opamp simulations into a single file
2024-07-21 [scripts] Major simplification in bulk capacitor calculation
2024-07-22 [kicad] added component numbers from jlcpcb [scripts] added bulk capacitor plot
    [CPU.kicad_sch, communication.kicad_sch, driver_fb_circuit.kicad_sch]
2024-07-23 [kicad] Added resistor footprints and mfr numbers, added switching circuit for USB_DP, [simulations] Made switching circuit simulation
    [CPU.kicad_sch, communication.kicad_sch, driver_fb_circuit.kicad_sch]
2024-07-23 [kicad] completed resistor and capacitor BOM, added footprints, streamlined the resistance and capacitance values | TODO: find new crystal, add footprint for CAN driver + button, check IC-footprints 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
    [CPU.kicad_sch, communication.kicad_sch, driver_fb_circuit.kicad_sch]
2024-07-24 [kicad] Added oscillator and relevant surrounding circuitry [scripts] Added resonator calculation
    [CPU.kicad_sch, communication.kicad_sch]
2024-07-25 fixed mismatched commit
    [CPU.kicad_sch]
2024-07-26 added footprint drawing
2024-07-27 [kicad] added soldering pads for phases and battery connectors, rearranged schematic, added tooling holes, fixed ERC errors [scripts] minor footprint calculations
    [CPU.kicad_sch, bldc_project.kicad_pcb, bldc_project.kicad_sch, driver_fb_circuit.kicad_sch, power.kicad_sch]
2024-07-28 [bldc] Fixed footprint issues, added jlcpcb man. rules, stackup decisions, added nets..
    [CPU.kicad_sch, bldc_project.kicad_pcb, bldc_project.kicad_sch, driver.kicad_sch, power.kicad_sch]
2024-07-30 [kicad] basic placement of everything but power and inverter, changed the ldo, changed caps
    [CPU.kicad_sch, bldc_project.kicad_pcb, driver.kicad_sch, power.kicad_sch]
2024-07-30 [kicad] positioning of single inverter stage
    [bldc_project.kicad_pcb, bldc_project.kicad_sch]
2024-07-31 [kicad] Removed ESD diodes for SWD, changed SWD resistor to smaller size
    [CPU.kicad_sch, bldc_project.kicad_pcb]
2024-08-01 started routing
    [bldc_project.kicad_pcb]
2024-08-01 [kicad] Experimented with component placing
    [CPU.kicad_sch, bldc_project.kicad_pcb]
2024-08-02 [bldc] did minor position changing
    [bldc_project.kicad_pcb]
2024-08-04 [kicad] Changed mounting hole to jlcpcb type, poured 2 gnd layers, started with traces.
    [bldc_project.kicad_pcb, power.kicad_sch]
2024-08-04 [kicad] Layout, mostly power traces + HS signal traces
    [CPU.kicad_sch, HRO_TYPE-C-31-M-12.step, SOIC8.STEP, bldc_project.kicad_pcb, power.kicad_sch]
2024-08-05 minor 10 V power plane changes + phase planes poured
    [bldc_project.kicad_pcb]
2024-08-06 [kicad] Routing bootstraps [cubemx] TODO: check feasibility of adc-signal switch on cpu
    [bldc_project.kicad_pcb]
2024-08-06 [kicad] Changed CPU adc / pwm inputs to facilitate routing
    [CPU.kicad_sch, bldc_project.kicad_pcb]
2024-08-06 Rough routing finished, checks next
    [CPU.kicad_sch, bldc_project.kicad_pcb]
2024-08-06 [kicad] Routing ERC completed, Minor footprint issues
    [bldc_project.kicad_pcb, power.kicad_sch]
2024-08-06 [kicad] Added silkscreen indicators for capacitors + screw terminal indications
    [bldc_project.kicad_pcb, driver.kicad_sch]
2024-08-06 [kicad] TODO: add silkscreen to FET-drivers, tantalum capacitors (check this first), FETs and other polar components OR check with manufacturer
    [bldc_project.kicad_pcb, driver.kicad_sch]
2024-08-06 [bldc] Added cathode indicators and capacitor polarity indicators | TODO: Check screw terminal pads, check for appropriate 3d model, check 3d model for button
    [bldc_project.kicad_pcb]
2024-08-08 [kicad] Added return vias, added copper pours to balance out thermal / mechanical effects
    [bldc_project.kicad_pcb]
2024-08-08 [kicad] changed some footprints | TODO: Fix footprint of USB-ESD protection, recheck components, fix ERC errors
    [bldc_project.kicad_pcb, bldc_project.kicad_sch, power.kicad_sch]
2024-08-08 fixed erc errors
    [bldc_project.kicad_pcb]
2024-08-09 [kicad] Done first set of footprint checks, adapted connector to regular phoenix connector, found 3d models for everything but button [scripts] Checked resonator calculation [simulations] Checked boo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
    [ATA6560-GAQW--3DModel-STEP-455599.STEP, CPU.kicad_sch, Texas_R-PUSON-N8_USON-8-1EP_1.6x2.1mm_P0.5mm_EP0.40x1.7mm.step, bldc_project.kicad_pcb, driver.kicad_sch, power.kicad_sch]
2024-08-09 [kicad] Fixed inductor footprints | TODO: integrate in actual pcb
    [power.kicad_sch]
2024-08-10 changed inductors, rearranged new FET footprints and symbols
    [bldc_project.kicad_pcb, driver.kicad_sch, power.kicad_sch]
2024-08-10 [kicad] Rechecked all footprints and components requirements | TODO: think about replacing the ESD package with something else [simulations] Checked simulations of buck converter with reality
    [CPU.kicad_sch, bldc_project.kicad_pcb, driver.kicad_sch, power.kicad_sch]
2024-08-11 [kicad] Added different ESD protection device, silkscreen indication on the back, [review] Added pdf file and images of the front and back as well as 3d images
    [CPU.kicad_sch, bldc_project.kicad_pcb, bldc_project.kicad_sch, driver.kicad_sch, power.kicad_sch]
2024-08-13 minor change
    [CPU.kicad_sch]
2024-08-15 [kicad] Added testpoints, added 1 amp fuses at 2 buck converters
    [CPU.kicad_sch, bldc_project.kicad_pcb, driver.kicad_sch, power.kicad_sch]
2024-08-15 [kicad] Added power and keepalive LED | TODO: Add extra mcu output
    [CPU.kicad_sch, bldc_project.kicad_pcb, power.kicad_sch]
2024-08-15 finished revision 1, generate gerbers and order
    [CPU.kicad_sch, bldc_project.kicad_pcb, power.kicad_sch]
2024-08-16 added LED GPIO output to cubemx
2024-08-16 [resources] Moved jupyter-lab scripts to resources folder, cleaned up image names
    [CPU.kicad_sch, bldc_project.kicad_pcb, bldc_project.kicad_sch, driver.kicad_sch, power.kicad_sch]
2024-08-23 started writing comments for jlcpcb
    [bldc_project.kicad_pcb, driver.kicad_sch]
2024-08-24 Exchanged button, 0.33 ohm resistor and 3-pin connectors with cheaper variants
    [CPU.kicad_sch, bldc_project.kicad_pcb, driver.kicad_sch, power.kicad_sch]
2024-08-25 Created BOM and gerbers
    [bldc_project-B_Cu.gbl, bldc_project-B_Mask.gbs, bldc_project-B_Paste.gbp, bldc_project-B_Silkscreen.gbo, bldc_project-Edge_Cuts.gm1, bldc_project-F_Cu.gtl, bldc_project-F_Mask.gts, bldc_project-F_Paste.gtp]
2024-08-29 rerouting SWD connector to 8x1 | TODO: regenerate gerbers
    [CPU.kicad_sch, bldc_project.kicad_pcb]
2024-08-30 [kicad] Added pinheader + did crc-check
    [CPU.kicad_sch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]
2024-09-01 [jlcpcb] Added gerbers, BOM, currently checking gerbers | TODO: Remove solder mask from larger pads
    [BOM.csv, CPU.kicad_sch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]
2024-09-03 moved everything into rev_1 folder, added final checks and tips for next design [jlcpcb] generated final gerber meant for ordering as well as BOM [kicad] Minor footprint and soldermask and copper mas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
    [ATA6560-GAQW--3DModel-STEP-455599.STEP, BOM.csv, CPU.kicad_sch, HRO_TYPE-C-31-M-12.step, SOIC8.STEP, Texas_R-PUSON-N8_USON-8-1EP_1.6x2.1mm_P0.5mm_EP0.40x1.7mm.step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]
2024-10-08 changed kicad library path according to freecad requirements
    [bldc_project.kicad_pcb]
2024-10-17 added initial code for bldc driver
2024-10-19 [boards] Updated board, [src] changed to usb example
2024-11-07 Got usb and printf up and running, next step: Full power, ADC and PWM checks
2024-11-07 [cube_ws] Added notes on how to register printf correctly
2024-12-03 [openems_trace_sims] Added folder for trace simulations using openems
    [ATA6560-GAQW--3DModel-STEP-455599.STEP, CPU.kicad_sch, HRO_TYPE-C-31-M-12.step, SOIC8.STEP, Texas_R-PUSON-N8_USON-8-1EP_1.6x2.1mm_P0.5mm_EP0.40x1.7mm.step, bldc_project.kicad_pcb, bldc_project.kicad_sch, communication.kicad_sch]
2024-12-04 [adc1_dma] Added adc project starter
2024-12-08 [fw] [cube_ws] adc working
2024-12-08 [cube_ws] [adc_usb] All adc's up and running
2024-12-08 [cube_ws] [adc_usb] got correct temperatures, test vbat | TODO: fix USB logging overflow issue
2024-12-08 [cube_ws] [adc_usb] adc fully working | switching to PWM
2024-12-10 [fw] [mco] Checked options with PWM for control, continue with master-slave triggering timers later
2024-12-15 [fw] [single_timer_interrupt] Implemented basic 6-step control sequence using timer interrupt
2025-01-19 [bringup] Doing fault analysis | TODO: flash NSD-low firmware onto the board
2025-01-22 [bringup] Modified bldc, discovered short | TODO: check short location with multimeter / thermal
2025-02-01 [bringup] Found reason for malfunction, waiting for BLDC motor for next tests
2025-03-27 [bug] Added extra todo for next version (adc source impedance reduction)
2025-05-17 [kicad] (minor) Added comments about bldc strategy
    [CPU.kicad_sch, bldc_project.kicad_pcb, bldc_project.kicad_sch, driver.kicad_sch, power.kicad_sch]
2025-12-07 kicad update
    [bldc_project.kicad_pcb]
