igorwolfs/bldc-hw/(notices)

Notices in the files:
rev_1/simulations/openems_trace_sims/kicad/3d_models/Texas_R-PUSON-N8_USON-8-1EP_1.6x2.1mm_P0.5mm_EP0.40x1.7mm.step:
Copyright (C) 2023, KiCAD
This work is licensed under the
[Creative Commons CC-BY-SA 4.0 License](https://creativecommons.org/licenses/by-sa/4.0/legalcode),
with the following exception:
project files under this or any other license agreement. However, if you wish to distribute
